gianlucarenzi/STM32F4XX/STM32F401/STM32F401-dimensions/STM32F401-DK1.dxf

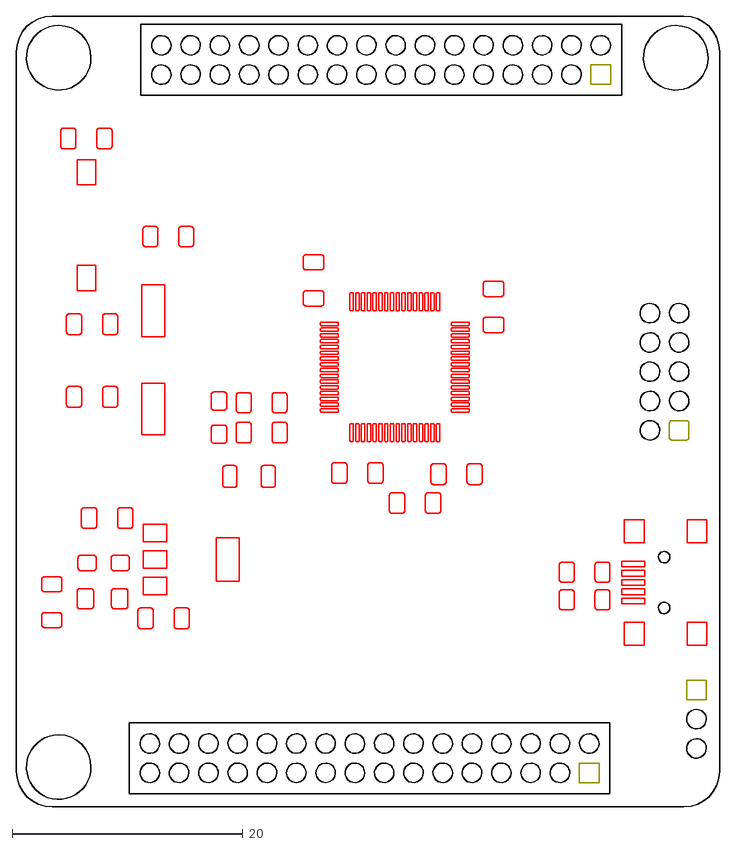
[picture p4: CAD file, 2022-01-11]
STM32F401/STM32F401-dimensions/STM32F401-DK1.dxf
61.0 x 68.6
