gianlucarenzi/STM32F4XX/STM32F401/STM32F4XX-brd.dxf

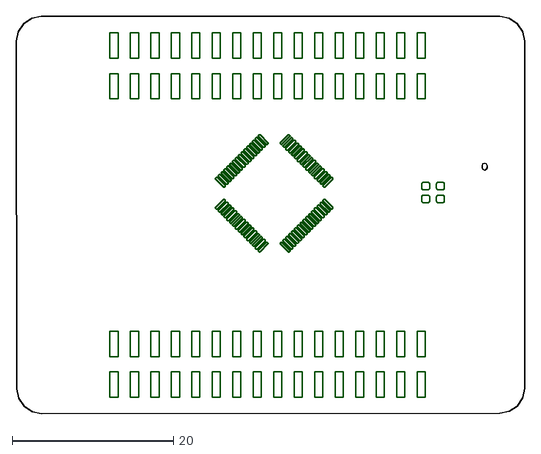
[picture p5: CAD file, 2025-11-03]
STM32F401/STM32F4XX-brd.dxf
63.0 x 49.2
