gianlucarenzi/STM32F4XX/STM32F401/STM32F4XX.pdf

# LOGO2 ¹² ¹⁰⁰nF

## POWER INPUT IS 5VDC

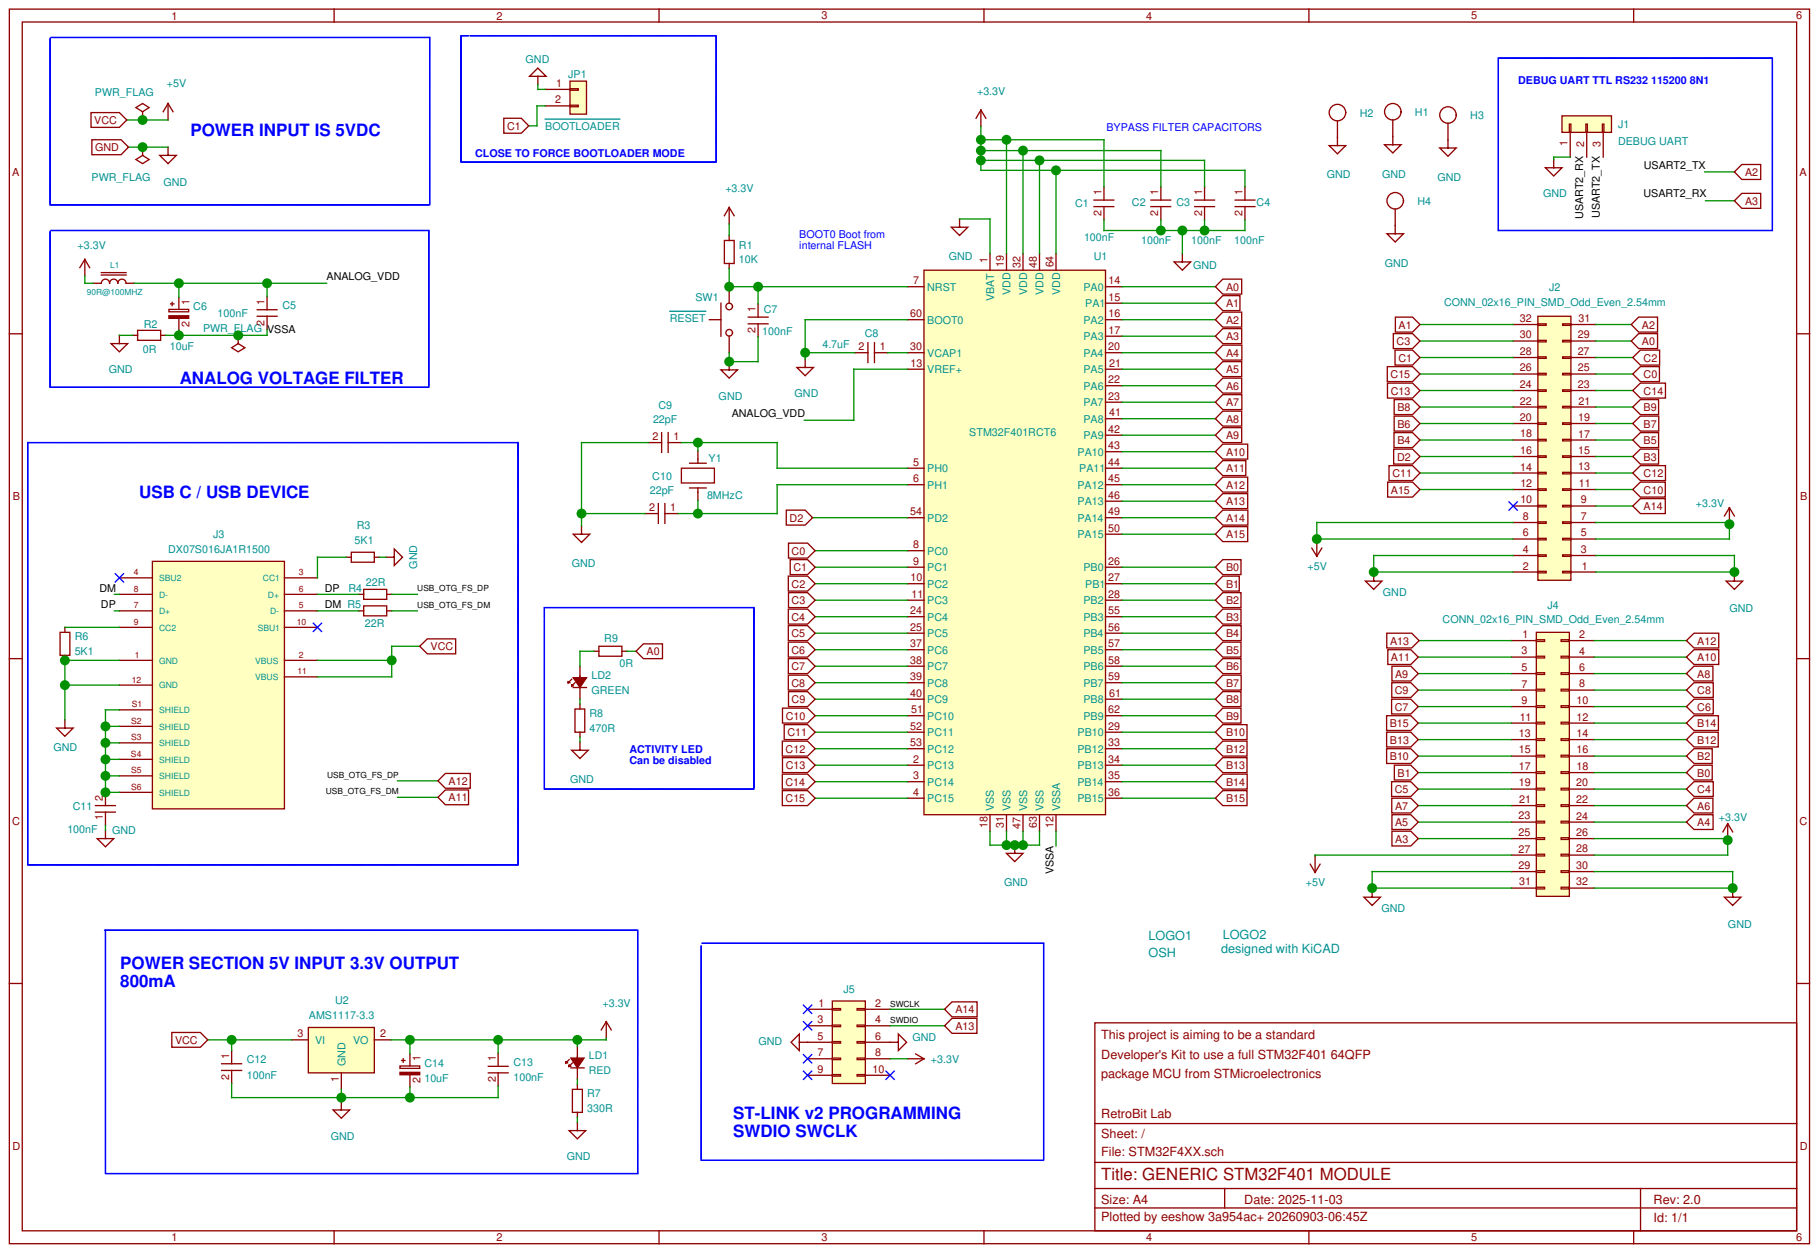
[picture p6: page 1]

DEBUG UART TTL RS232 115200 8N1 GND | J1 A2 USART2_TX USART2_RX A3

CLOSE TO FORCE BOOTLOADER MODE

+3.3V 0R GND | ANALOG VOLTAGE FILTER

POWER SECTION 5V INPUT 3.3V OUTPUT

This project is aiming to be a standard
Developer's Kit to use a full STM32F401 64QFP
package MCU from STMicroelectronics
