gianlucarenzi/STM32F4XX/STM32F401/STM32F401-schematics.pdf

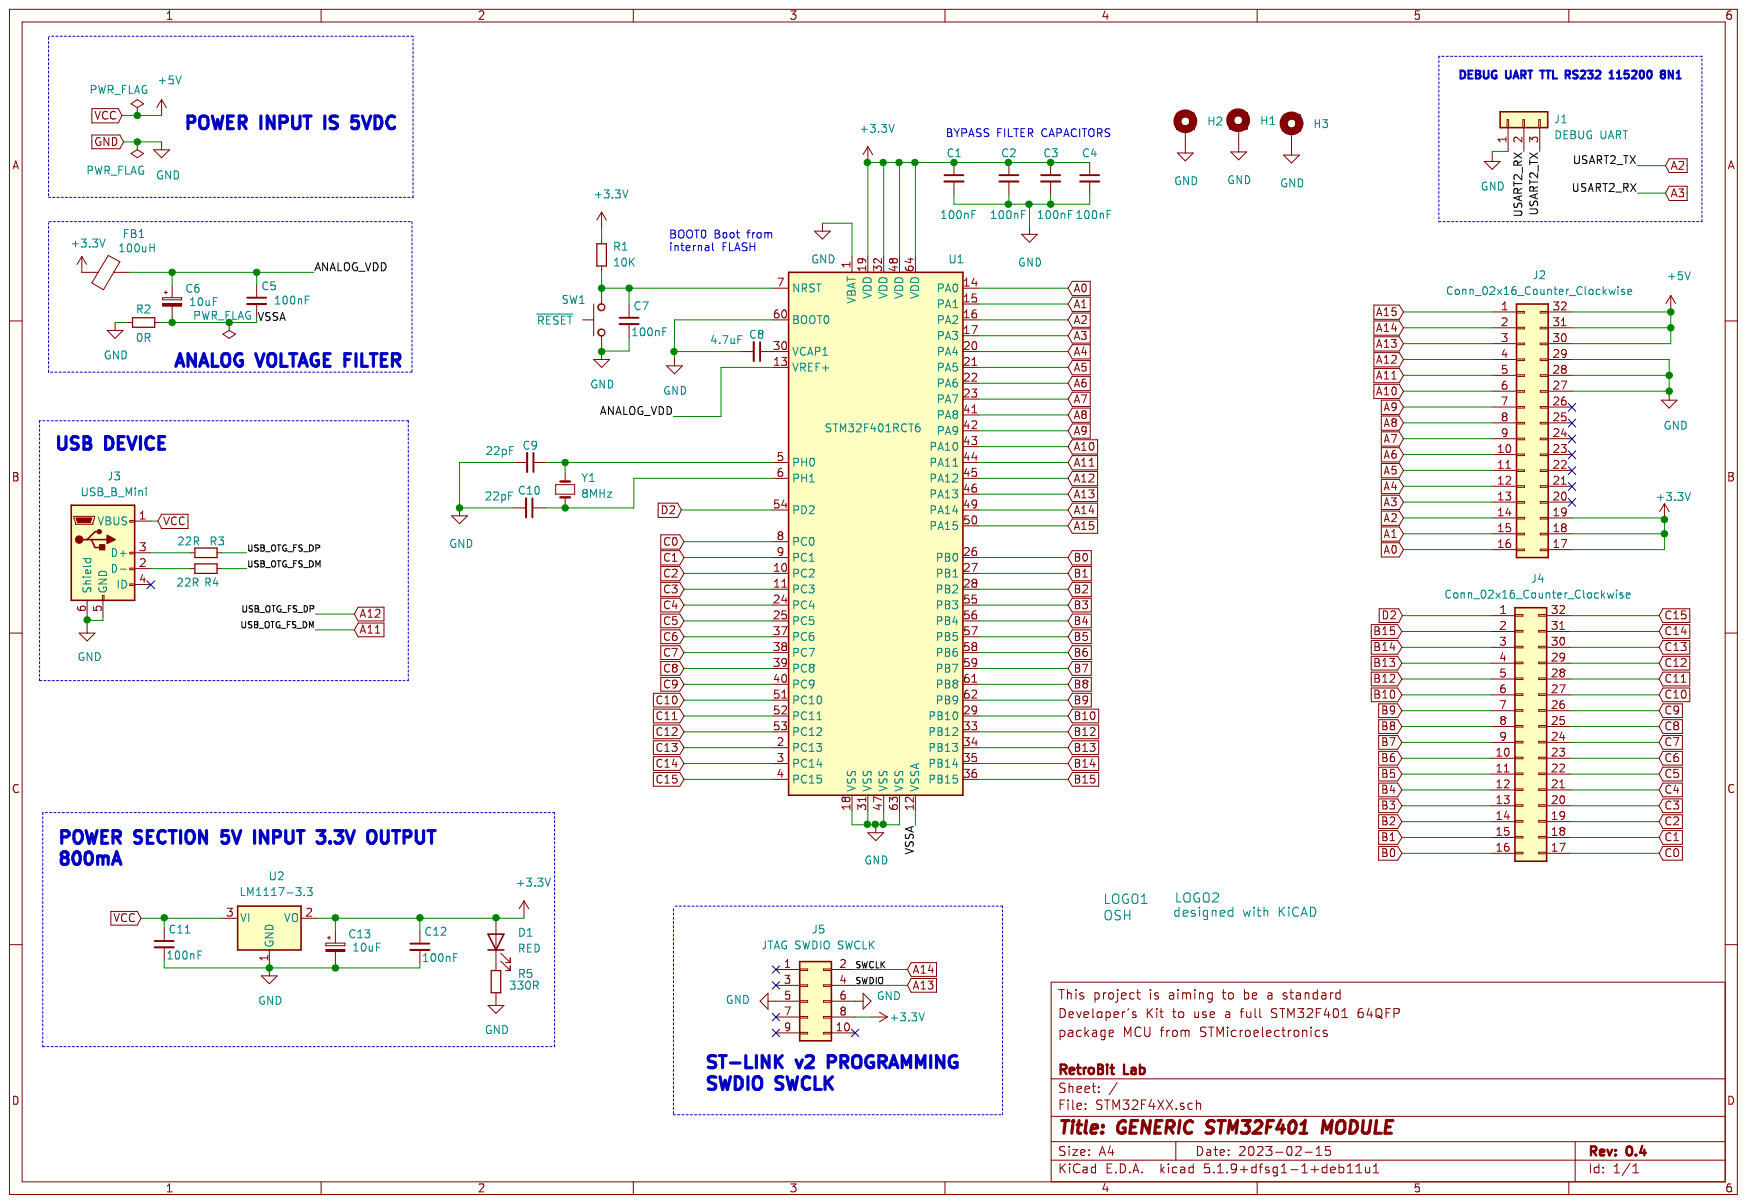
[picture p7: page 1]
