gianlucarenzi/STM32F4XX/(list of files, drawings)

Other design files:
STM32F401/STM32F4XX.dsn
