gianlucarenzi/STM32F4XX/STM32F401/STM32F4XX.kicad_pcb

## KiCad design STM32F401/STM32F4XX.kicad_pcb (2025-11-03)

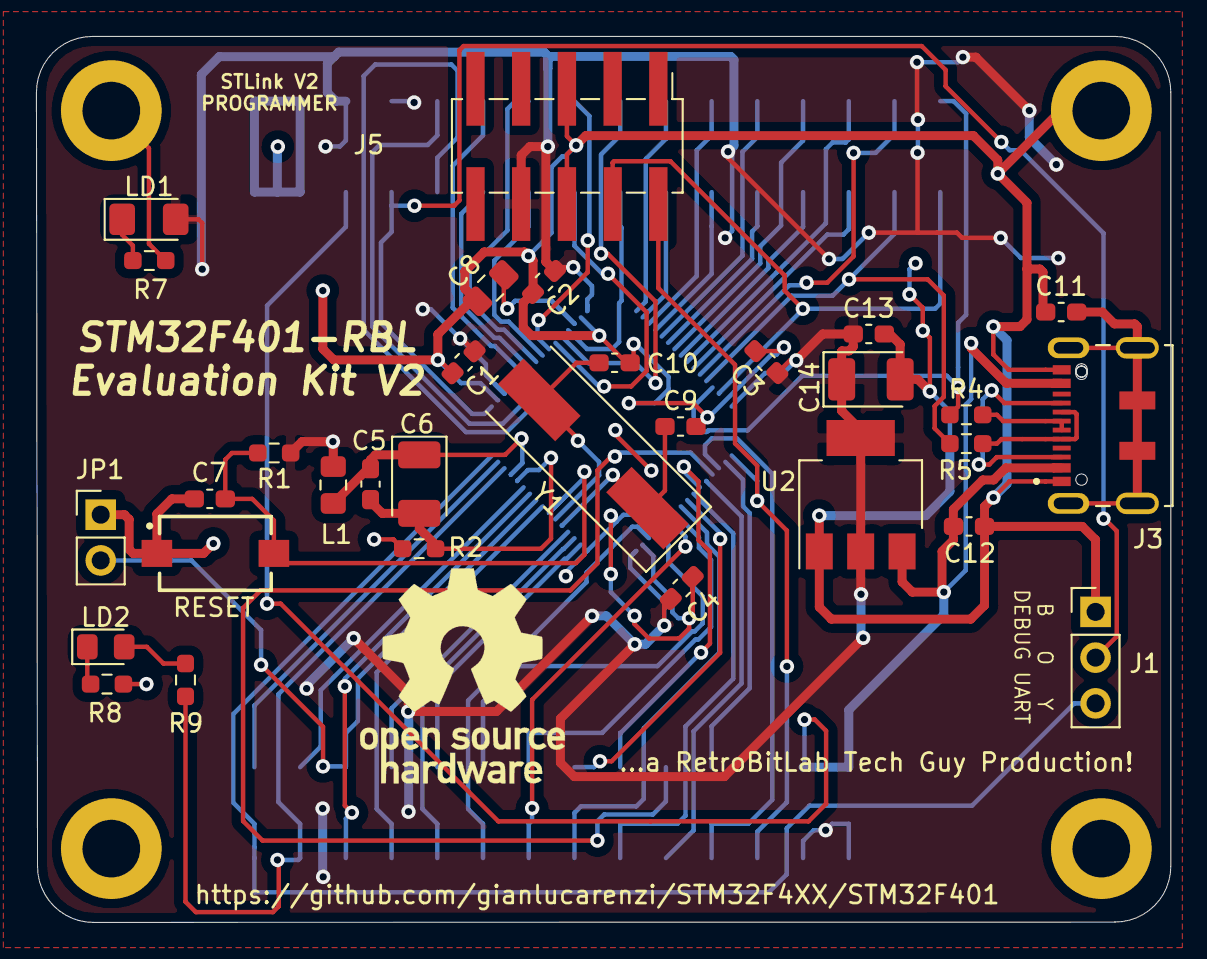
[picture p8: board STM32F4XX.kicad_pcb from above]

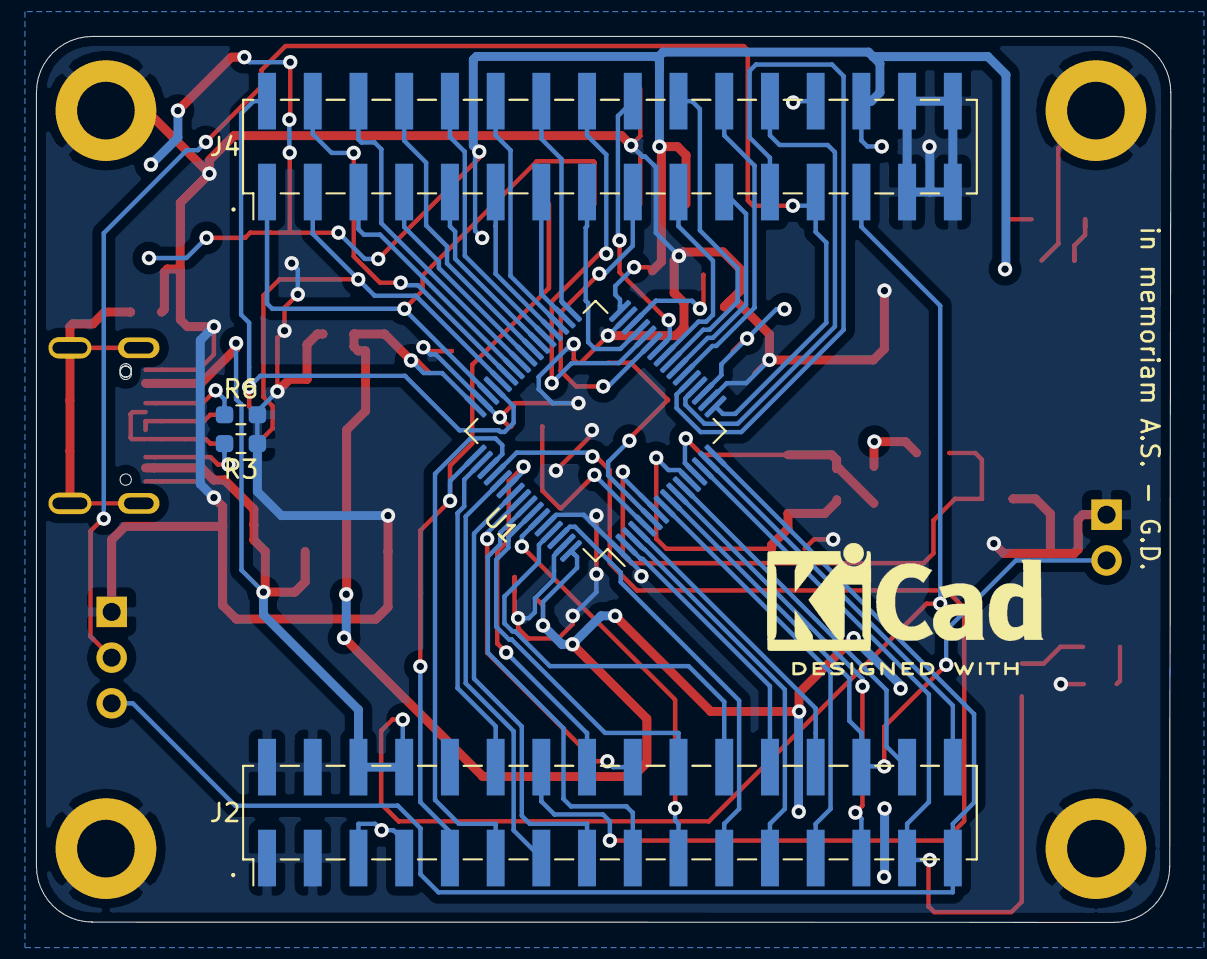
[picture p9: board STM32F4XX.kicad_pcb from below]

Board: 2 copper layers, 63.0 x 49.2 mm, 42 parts (6 on the bottom side), 65 nets.

Parts:
C1, C2, C3, C4, C5, C7, C11, C12, C13: 100nF; C_0603_1608Metric_Pad1.08x0.95mm_HandSolder
C6, C14: 10uF; CP_EIA-3528-12_Kemet-T_Pad1.50x2.35mm_HandSolder
C8: 4.7uF; C_0805_2012Metric_Pad1.18x1.45mm_HandSolder
C9, C10: 22pF; C_0603_1608Metric_Pad1.08x0.95mm_HandSolder
H1, H2, H3, H4: MountingHole_Pad; MountingHole_3.2mm_M3_DIN965_Pad
J1: DEBUG UART; PinHeader_1x03_P2.54mm_Vertical
J2, J4: CONN_02x16_PIN_SMD_Odd_Even_2.54mm; PinHeader_2x16_P2.54mm_Vertical_SMD
J3: DX07S016JA1R1500; JAE_DX07S016JA1R1500
J5: CONN_SMD_HEADER_BOX_02x05_Odd_Even_2.54mm; IDC-Header_2x05_P2.54mm_Vertical_SMD
JP1: ~BOOTLOADER; PinHeader_1x02_P2.54mm_Vertical
L1: 90R@100MHZ; L_0805_2012Metric_Pad1.15x1.40mm_HandSolder
LD1: RED; LED_1206_3216Metric_Pad1.42x1.75mm_HandSolder
LD2: GREEN; LED_0805_2012Metric_Pad1.15x1.40mm_HandSolder
LOGO1: OSH; OSHW-Logo_11.4x12mm_SilkScreen
LOGO2: designed with KiCAD; KiCad-Logo2_6mm_SilkScreen
R1: 10K; R_0603_1608Metric_Pad0.98x0.95mm_HandSolder
R2, R9: 0R; R_0603_1608Metric_Pad0.98x0.95mm_HandSolder
R3, R6: 5K1; R_0603_1608Metric_Pad0.98x0.95mm_HandSolder
R4, R5: 22R; R_0603_1608Metric_Pad0.98x0.95mm_HandSolder
R7: 330R; R_0603_1608Metric_Pad0.98x0.95mm_HandSolder
R8: 470R; R_0603_1608Metric_Pad0.98x0.95mm_HandSolder
SW1: ~RESET; SPST-7.3x3.9x2.5-WUERTH-434121025816
U1: STM32F401RCT6; LQFP-64_10x10mm_P0.5mm
U2: AMS1117-3.3; SOT-223-3_TabPin2
Y1: 8MHzC; Crystal_SMD_HC49-SD

Connections:
+3V3: C1.1, C2.1, C3.1, C4.1, C13.1, C14.1, J2.5, J2.7, J4.26, J4.28, J5.8, L1.1, LD1.2, R1.1, U1.19, U1.32, U1.48, U1.64, U2.2
/ANALOG_VDD: C5.1, C6.1, L1.2, U1.13
/DM: J3.5, J3.8, R5.2
/DP: J3.6, J3.7, R4.2
/VSSA: C5.2, C6.2, R2.2, U1.12
A0: J2.29, R9.1, U1.14
A1: J2.32, U1.15
A2: J1.3, J2.31, U1.16
A3: J1.2, J4.25, U1.17
A4: J4.24, U1.20
A5: J4.23, U1.21
A6: J4.22, U1.22
A7: J4.21, U1.23
A8: J4.6, U1.41
A9: J4.5, U1.42
A10: J4.4, U1.43
A11: J4.3, R5.1, U1.44
A12: J4.2, R4.1, U1.45
A13: J4.1, J5.4, U1.46
A14: J2.9, J5.2, U1.49
A15: J2.12, U1.50
B0: J4.18, U1.26
B1: J4.17, U1.27
B2: J4.16, U1.28
B3: J2.15, U1.55
B4: J2.18, U1.56
B5: J2.17, U1.57
B6: J2.20, U1.58
B7: J2.19, U1.59
B8: J2.22, U1.61
B9: J2.21, U1.62
B10: J4.15, U1.29
B12: J4.14, U1.33
B13: J4.13, U1.34
B14: J4.12, U1.35
B15: J4.11, U1.36
C0: J2.25, U1.8
C1: J2.28, JP1.2, U1.9
C2: J2.27, U1.10
C3: J2.30, U1.11
C4: J4.20, U1.24
C5: J4.19, U1.25
C6: J4.10, U1.37
C7: J4.9, U1.38
C8: J4.8, U1.39
C9: J4.7, U1.40
C10: J2.11, U1.51
C11: J2.14, U1.52
C12: J2.13, U1.53
C13: J2.24, U1.2
C14: J2.23, U1.3
C15: J2.26, U1.4
D2: J2.16, U1.54
GND: C1.2, C2.2, C3.2, C4.2, C7.2, C8.2, C9.2, C10.2, C11.1, C12.2, C13.2, C14.2, H1.1, H2.1, H3.1, H4.1, J1.1, J2.1, J2.2, J2.3, J2.4, J3.1, J3.12, J4.29, J4.30, J4.31, J4.32, J5.5, J5.6, JP1.1, R2.1, R3.1, R6.2, R7.2, R8.2, SW1.1, U1.1, U1.18, U1.31, U1.47, U1.60, U1.63, U2.1
unnamed: C7.1, R1.2, SW1.2, U1.7
unnamed: C8.1, U1.30
unnamed: C9.1, U1.5, Y1.1
unnamed: C10.1, U1.6, Y1.2
unnamed: C11.2, J3.S1, J3.S2, J3.S3, J3.S4, J3.S5, J3.S6
unnamed: J3.3, R3.2
unnamed: J3.9, R6.1
unnamed: LD1.1, R7.1
unnamed: LD2.1, R8.1
unnamed: LD2.2, R9.2
VCC: C12.1, J2.6, J2.8, J3.2, J3.11, J4.27, U2.3
