gianlucarenzi/STM32F4XX/(commit log)

2022-01-11 Sent to JLCPCB for production (missing some silkscreen information)
    [STM32F4XX_bom_jlc.csv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]
2022-01-11 Schematic added
2022-01-11 Removed unused backup Added Schematics
2022-01-11 Modified for JLCPCB production and added some silkscreens
    [STM32F4XX.dsn, STM32F4XX.kicad_pcb, STM32F4XX.sch]
2022-01-11 Production files sent to JLCPCB for SMT assembly and PCB manufacturing (missing some silkscreen information)
    [STM32F4XX-B_Cu.gbl, STM32F4XX-B_Mask.gbs, STM32F4XX-B_Paste.gbp, STM32F4XX-B_SilkS.gbo, STM32F4XX-Edge_Cuts.gm1, STM32F4XX-F_Cu.gtl, STM32F4XX-F_Mask.gts, STM32F4XX-F_Paste.gtp]
2022-01-11 Mechanical Drawings stuff
    [STM32F401-DK1.dxf]
2022-01-11 Updated with the new slikscreens & comments
    [STM32F4XX.sch]
2022-02-04 Updated fp info cache with STM32F401-DK
2022-02-05 Interactive BOM for manual soldering
    [STM32F4XX.csv]
2022-02-05 Added KiCAD logo on back silkscreen
    [STM32F4XX-B_Cu.gbl, STM32F4XX-B_Mask.gbs, STM32F4XX-B_Paste.gbp, STM32F4XX-B_SilkS.gbo, STM32F4XX-Edge_Cuts.gm1, STM32F4XX-F_Cu.gtl, STM32F4XX-F_Mask.gts, STM32F4XX-F_Paste.gtp]
2022-02-05 Added KiCAD loAdded KiCAD logo on back silkscreen
    [STM32F4XX.kicad_pcb, STM32F4XX.sch]
2022-02-05 Updated without silkscreen data on back. Only strings
2022-02-05 Ultra simple JLCPCB LCSC Part selection.
    [STM32F4XX_bom_jlc.csv]
2022-02-05 Script to create JLCPCB as the export tool in schematics.
2022-02-05 Sent to JLCPCB
    [STM32F4XX_cpl_bot.csv, STM32F4XX_cpl_top.csv]
2022-02-05 Added RESET switch
    [STM32F4XX.sch, STM32F4XX_bom_jlc.csv]
2022-02-07 Updated footprint for RESET switch. It will a 7.3x3.9x2.5 mm like a Wuerth 434121025816
    [STM32F4XX.sch]
2022-02-08 Updated for new RESET switch as per JLCPCB request. E-mail beginning of Feb.2022
2022-02-08 Rotated. Strangely JLCPCB gives me the wrong orientation for this...
    [STM32F4XX_cpl_top.csv]
2022-02-08 New revision 0.3
    [STM32F4XX.kicad_pcb, STM32F4XX.sch]
2022-11-05 Imported from Serasidis/STM32_HID_Bootloader
2022-11-05 Bootloader mode: powerup with ESC + LCTRL + SPACEBAR PRESSED within 2 seconds
2023-02-15 Modified the USB+ and USB- pins. BOY UART
2023-02-15 V0.4 USB+ and USB- bug, BOY UART
    [STM32F4XX.dsn, STM32F4XX.kicad_pcb, STM32F4XX.sch]
2023-02-16 Mandatory PINS: GPIOA0 for LED (ground means ON) GPIOC1 for BOOT MODE (ground for 1 second at startup means DFU MODE)
2023-02-18 Ignore the TOO BIG Files STM32Cube-Programmer for various Operating Systems
2023-05-10 Committed. If it is wrong I will change it again later.
    [STM32F4XX_cpl_top.csv]
2025-10-12 For OpenOCD setup
    [stm32f4eval.cfg]
2025-10-30 Start transition to a smaller board. Using smallest components footprint
    [STM32F4XX.csv, STM32F4XX.kicad_pcb, STM32F4XX.sch]
2025-11-01 RetroBitLab library instead of AmigaComponents
    [STM32F4XX.sch]
2025-11-03 New board. Smaller
    [STM32F4XX-B_Cu.gbl, STM32F4XX-B_Mask.gbs, STM32F4XX-B_Paste.gbp, STM32F4XX-B_SilkS.gbo, STM32F4XX-Edge_Cuts.gm1, STM32F4XX-F_Cu.gtl, STM32F4XX-F_Mask.gts, STM32F4XX-F_Paste.gtp]
2025-11-03 First try with an autorouter. Completed by hand
    [STM32F4XX.dsn]
2025-11-03 V2.0 Smaller
    [STM32F4XX.sch]
2025-11-03 Used for creating footprint of STM32F4XX_BOARD
    [STM32F4XX-brd.dxf]
2025-11-03 Removed. Not needed for autogeneration
    [STM32F4XX.csv, STM32F4XX_bom_jlc.csv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]
2025-11-03 Added openocd script for flashing with STLink V2
    [stm32f4eval.cfg]
2025-11-03 Added VSCode configuration files for STM32 HID Bootloader project
2025-11-12 From other projects
    [stm32f4eval.cfg]
2025-11-12 Jump with interrupts disabled
2026-09-03 Fix eeplot PDF export: keep each schematic sheet's own page size
    eeplot forced every page of the exported PDF to the size of the largest
    sheet, anchoring smaller sheets top-left instead of keeping their native
    paper size (same fix as applied in Vera-Module-RBL-XE). Patch
    record_wipe()/cr_pdf_end() so each page is sized and offset from its own
    bounding box, and wire patch application into output_job.sh's eeplot
    build/update steps. Regenerated STM32F4XX.pdf with the fix.
