gianlucarenzi/STM32F4XX/(notices)

Notices in the files:
STM32F401/STM32_HID_Bootloader/Core/Src/main.c:
Copyright (c) 2025 STMicroelectronics.
All rights reserved.
This software is licensed under terms that can be found in the LICENSE file
